RDickens/Packing-Machine/Documentation/Wiring Diagram.pdf

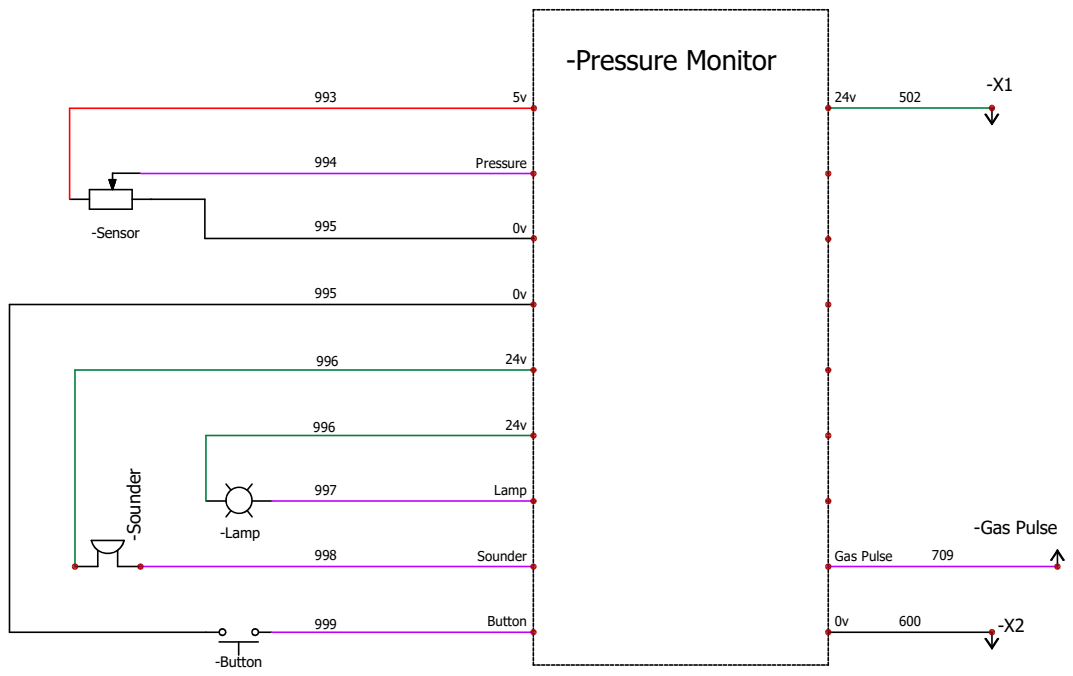
[picture p2: page 1]
-Pressure Monitor; Pressure; Lamp; Sounder; Button; Gas Pulse; -Sounder -Lamp; -Button; -Sensor; -Gas Pulse
